Wojtascythe/lightsaber/ETAPIII/1.jpg

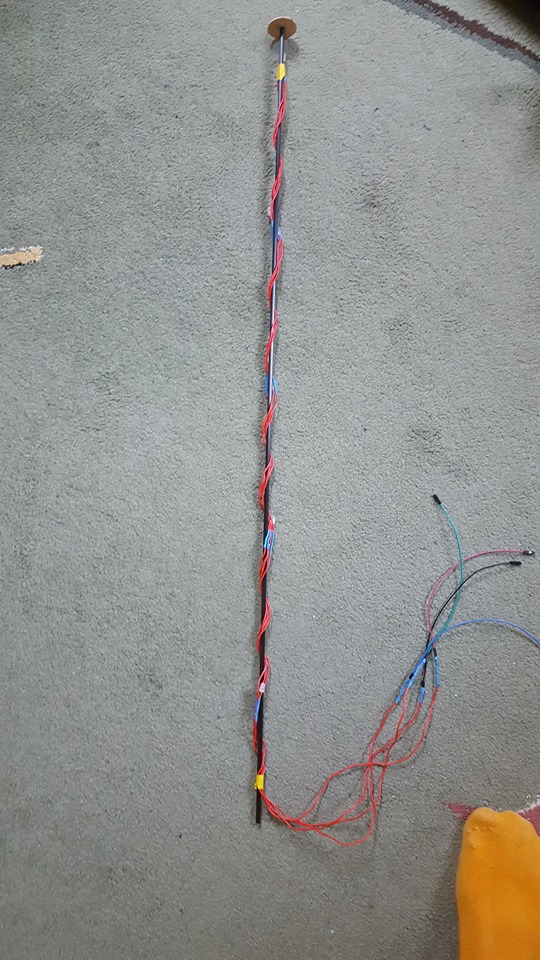
ETAPIII/1.jpg
