Wojtascythe/lightsaber/ETAPIII/5.jpg

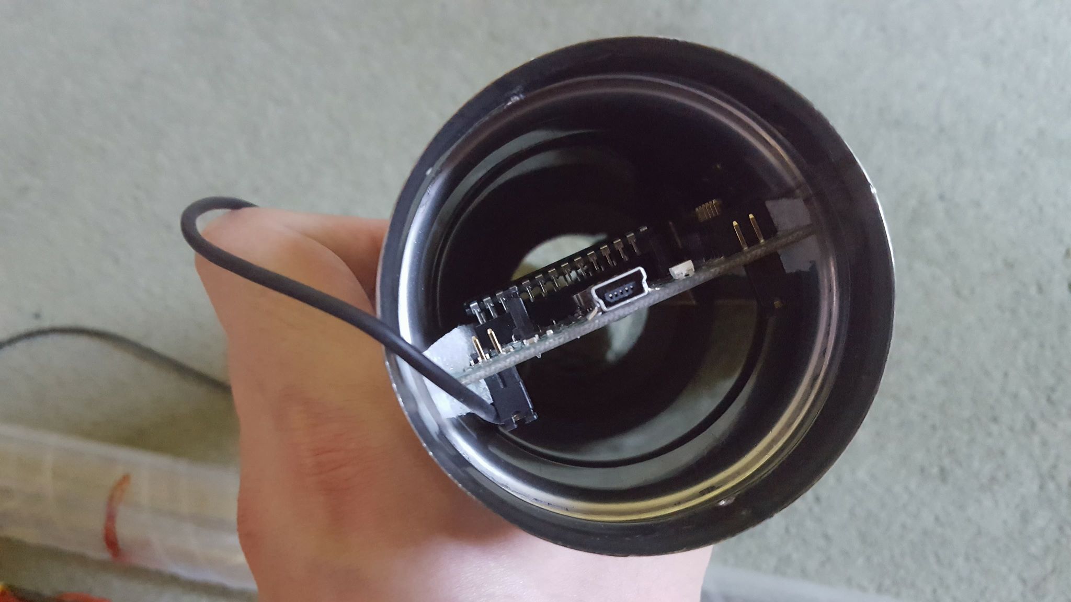
ETAPIII/5.jpg
