Wojtascythe/lightsaber/ETAPIII/7.jpg

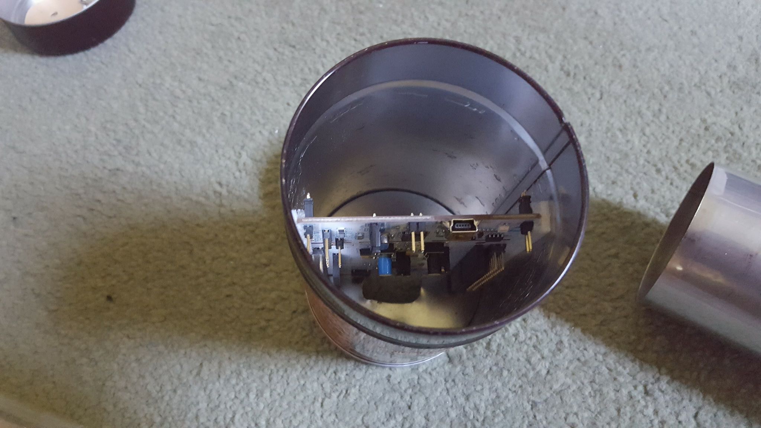
ETAPIII/7.jpg
