Wojtascythe/lightsaber/ETAPIII/8.jpg

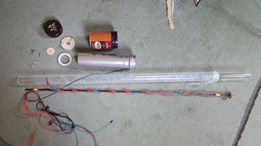
ETAPIII/8.jpg
