Wojtascythe/lightsaber/ETAPIII/10.jpg

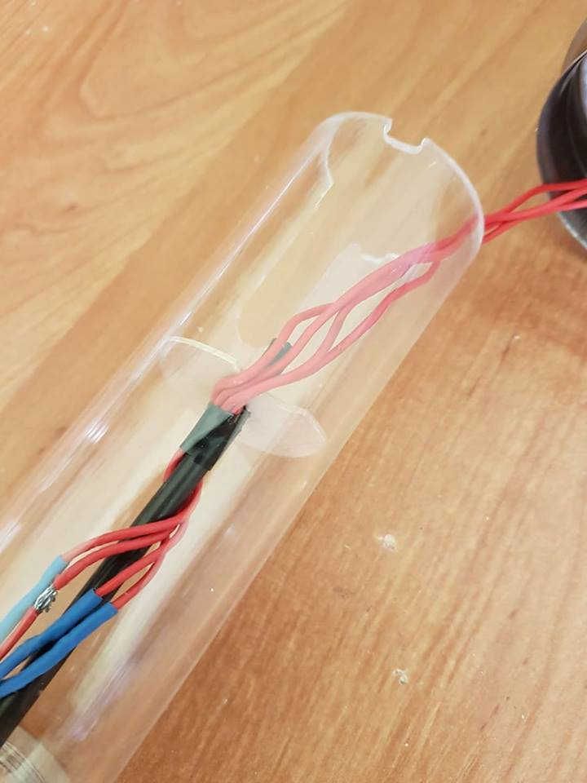
ETAPIII/10.jpg
