Wojtascythe/lightsaber/ETAPIII/14.jpg

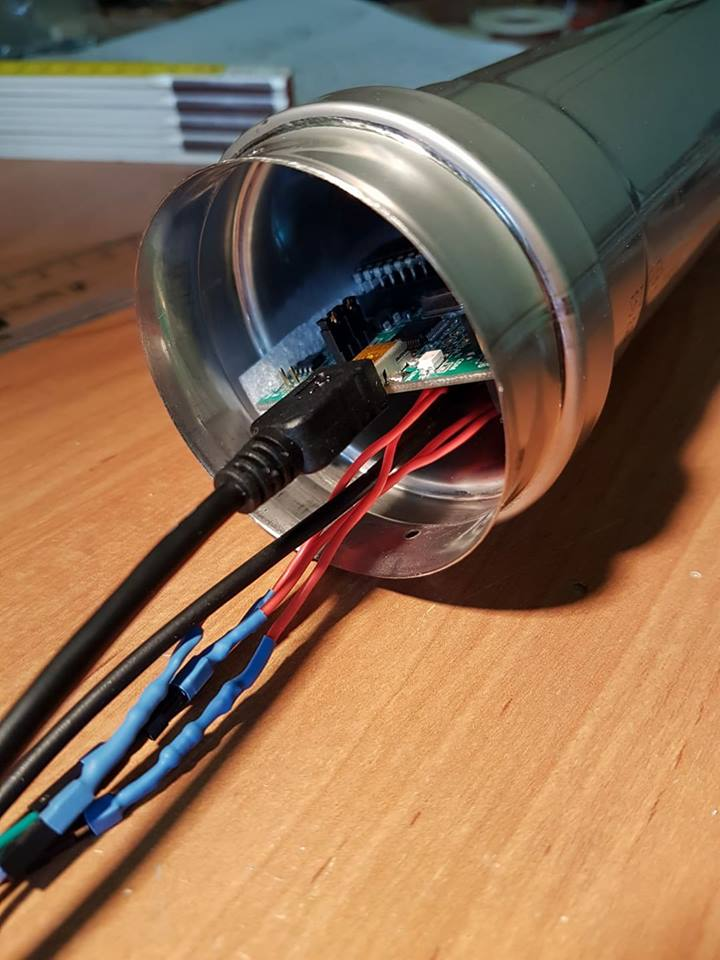
ETAPIII/14.jpg
