Wojtascythe/lightsaber/ETAPIII/15.jpg

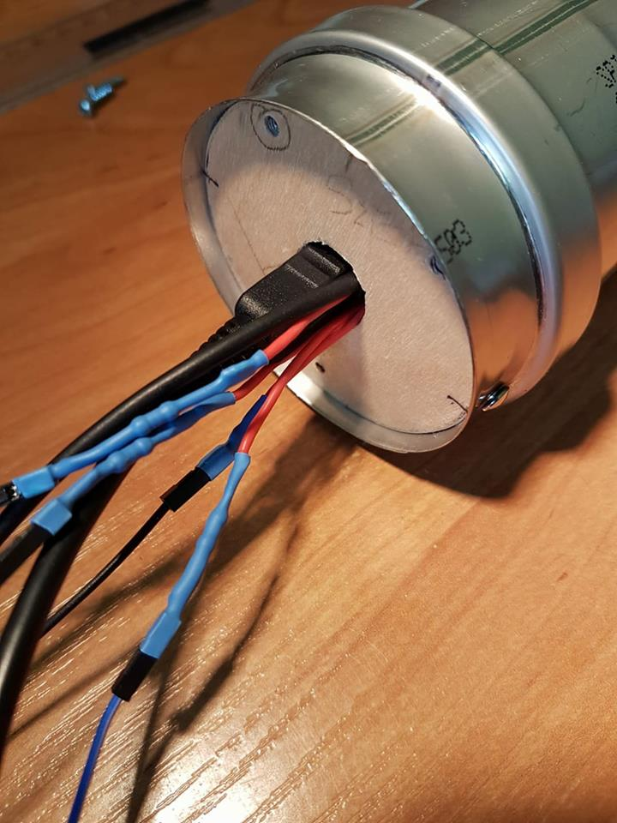
ETAPIII/15.jpg
