Wojtascythe/lightsaber/ETAPIII/16.jpg

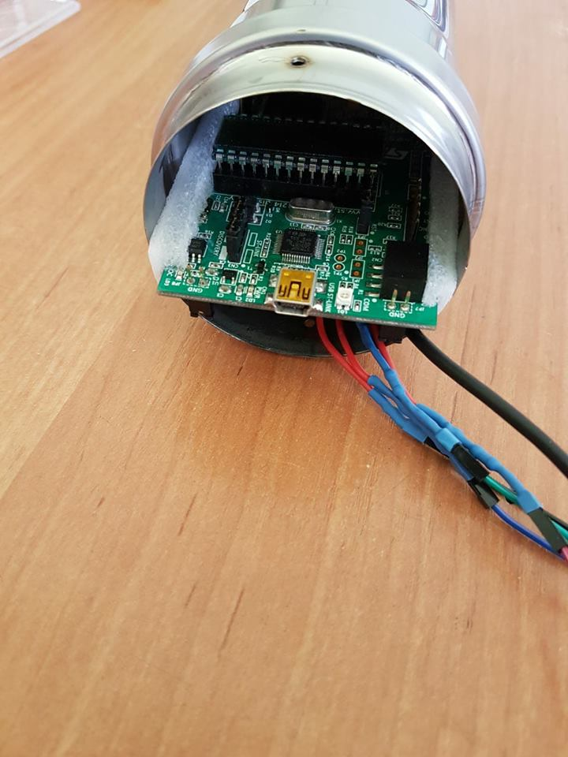
ETAPIII/16.jpg
