Wojtascythe/lightsaber/ETAPIII/17.jpg

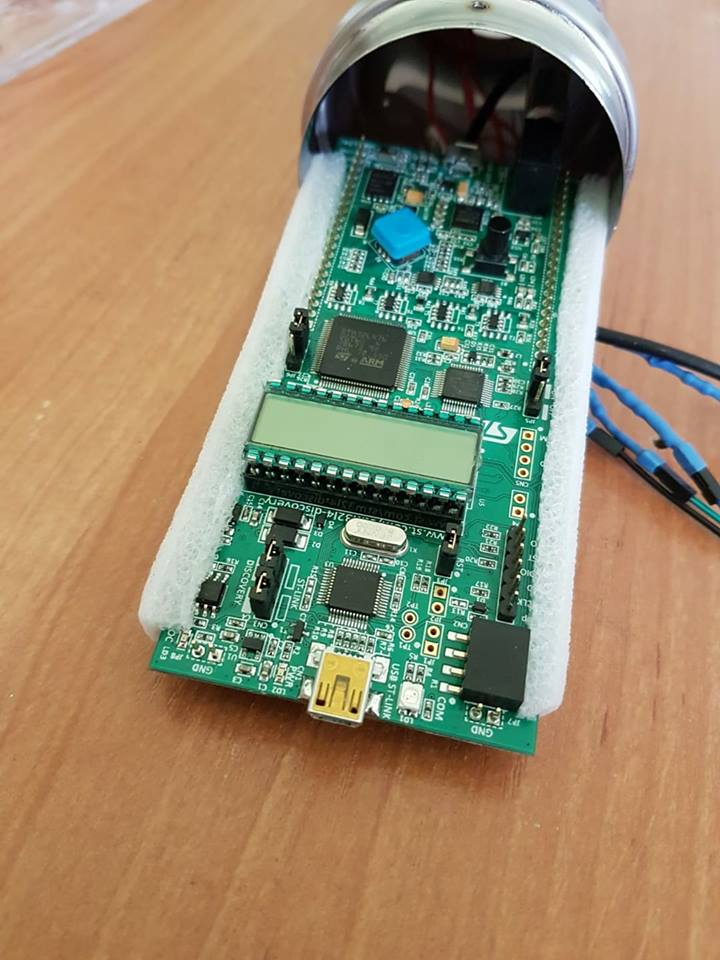
ETAPIII/17.jpg
