Wojtascythe/lightsaber/ETAPIII/18.jpg

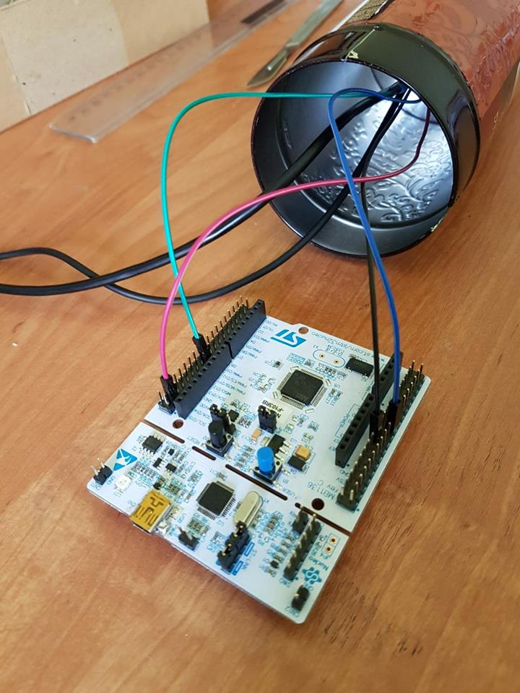
ETAPIII/18.jpg
