Wojtascythe/lightsaber/ETAPIII/20.jpg

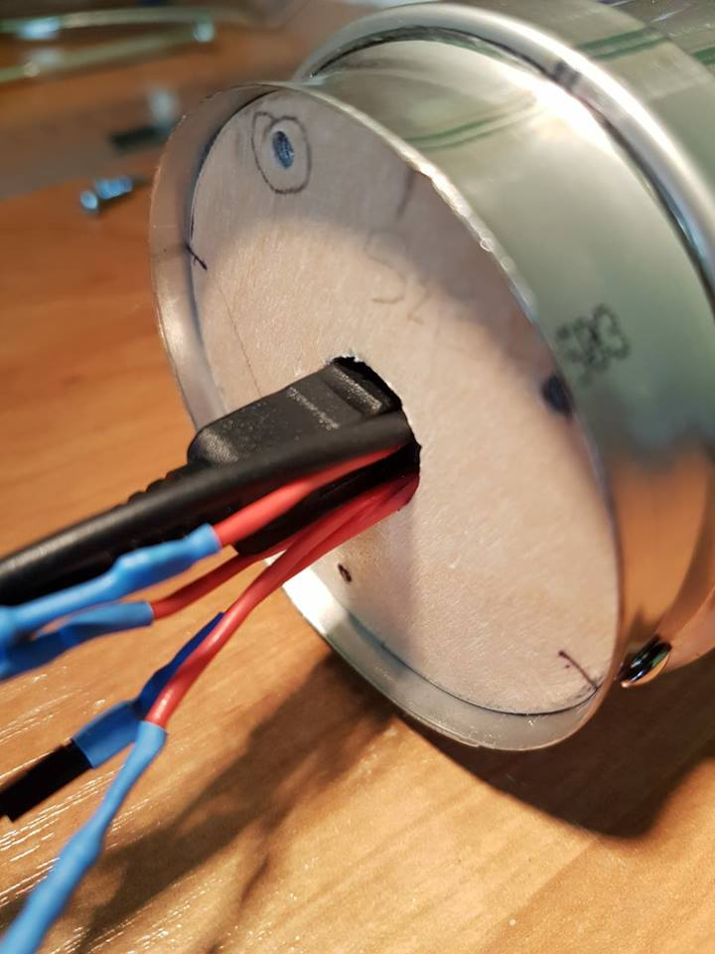
ETAPIII/20.jpg
