Wojtascythe/lightsaber/software/arm_firmware/Src/main.c

/**
  ******************************************************************************
  * @file           : main.c
  * @brief          : Main program body
  ******************************************************************************
  ** This notice applies to any and all portions of this file
  * that are not between comment pairs USER CODE BEGIN and
  * USER CODE END. Other portions of this file, whether 
  * inserted by the user or by software development tools
  * are owned by their respective copyright owners.
  *
  * COPYRIGHT(c) 2018 STMicroelectronics
  *
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
  ******************************************************************************
  */
/* Includes ------------------------------------------------------------------*/
#include "main.h"
#include "stm32l4xx_hal.h"
#include "dfsdm.h"
#include "dma.h"
#include "i2c.h"
#include "sai.h"
#include "spi.h"
#include "usart.h"
#include "gpio.h"

/* USER CODE BEGIN Includes */
#include "gyros.h"
#include "accel.h"

#include "stm32l476g_discovery_gyroscope.h"
#include "stm32l476g_discovery_compass.h"
#include "stm32l476g_discovery_audio.h"

#include "math.h"
#include "sample.h"

#define BASE_FREQ 400.0f
/* USER CODE END Includes */


/* USER CODE BEGIN PV */
uint8_t Received[10];
int32_t RemainingAudioSamplesNb;
volatile uint16_t * frameData, *genData;
uint16_t buffor1[800], buffor2[800];
volatile float cc = 0.0;
volatile uint8_t audioFlag = 0;

/* USER CODE END PV */

void SystemClock_Config(void);

/* USER CODE BEGIN PFP */
void AudioPlay_TransferComplete_CallBack() {
	if (audioFlag == 1) {
		if (frameData == buffor1) {
			frameData = buffor2;
		} else {
			frameData = buffor1;
		}
		audioFlag = 0;
	}

//	if(cc > 2.0){
//				frameData = light_saber_sample_move;
//
//			}else{
//				frameData = light_saber_sample_idle;
//
//			}


	if (BSP_AUDIO_OUT_Play(frameData, RemainingAudioSamplesNb) != AUDIO_OK) {
		HAL_GPIO_WritePin(LD_R_GPIO_Port, LD_R_Pin, SET);
		Error_Handler();
	} else {
		HAL_GPIO_TogglePin(LD_G_GPIO_Port, LD_G_Pin);
	}

}
void AudioPlay_Error_CallBack(void) {
	/* Stop the program with an infinite loop */
	HAL_GPIO_WritePin(LD_R_GPIO_Port, LD_R_Pin, SET);
	Error_Handler();
}

/* USER CODE END PFP */

/**
  * @brief  The application entry point.
  *
  * @retval None
  */
int main(void)
{
  /* USER CODE BEGIN 1 */
	float sampleRate = 8000.0; // hertz
	float freq = BASE_FREQ;         // hertz
	float duration = 0.1;       // seconds

	/* Gyroscope variables */
	uint8_t message[100], characters_count;
	int16_t buffer[3];
	float x, y, z;
	float nSamples = (duration * sampleRate);
	uint16_t i;
	uint8_t wiadom[100];
	uint8_t char_count;
	int16_t buffa[3] = { 0 };
	float buffg[3] = { 0 };
	float xa, ya, za, va = 0.0, xaa = 0.0, yaa = 0.0, zaa = 0.0;
	float xg, yg, zg;
	uint32_t interval = 0, prev = 0, current = 0;

	frameData = buffor1;
	//frameData = light_saber_sample;
  /* USER CODE END 1 */

  /* MCU Configuration----------------------------------------------------------*/

  /* Reset of all peripherals, Initializes the Flash interface and the Systick. */
  HAL_Init();

  /* Configure the system clock */
  SystemClock_Config();

  /* Initialize all configured peripherals */
  MX_GPIO_Init();
  MX_DMA_Init();
  MX_SAI1_Init();
  MX_I2C1_Init();
  MX_SPI2_Init();
  MX_USART2_UART_Init();
  MX_DFSDM1_Init();
  /* USER CODE BEGIN 2 */
	HAL_GPIO_WritePin(LD_G_GPIO_Port, LD_G_Pin, RESET);
	HAL_GPIO_WritePin(LD_R_GPIO_Port, LD_R_Pin, RESET);

	for (i = 0; i < (uint32_t) nSamples; ++i) {
		buffor1[i] = (uint16_t) ((sin(
				freq * (float) i * 6.28 / sampleRate) + 1.0) * 32000);
	}


	if (ZYROS_Init() != Zyros_ok) {
		HAL_GPIO_WritePin(LD_R_GPIO_Port, LD_R_Pin, SET);
		/* Initialization Error */
		Error_Handler();
	}

	if (AKCEL_Init() != Akcel_ok) {
		HAL_GPIO_WritePin(LD_R_GPIO_Port, LD_R_Pin, SET);
		/* Initialization Error */
		Error_Handler();
	}

	RemainingAudioSamplesNb = 800; //sizeof(light_saber_sample)/sizeof(uint16_t); //1600;//(uint32_t)nSamples;
	HAL_GPIO_WritePin(LD_R_GPIO_Port, LD_R_Pin, RESET);
	if (BSP_AUDIO_OUT_Init(OUTPUT_DEVICE_HEADPHONE, 60, 8000) != AUDIO_OK) {
		HAL_GPIO_WritePin(LD_R_GPIO_Port, LD_R_Pin, SET);
		Error_Handler();       //dajemy sygnal error
	}

	BSP_AUDIO_OUT_RegisterCallbacks(AudioPlay_Error_CallBack,
	NULL, AudioPlay_TransferComplete_CallBack);

	if (BSP_AUDIO_OUT_Play(frameData, RemainingAudioSamplesNb) != AUDIO_OK) {
		HAL_GPIO_WritePin(LD_R_GPIO_Port, LD_R_Pin, SET);

		Error_Handler();
	}

  /* USER CODE END 2 */

  /* Infinite loop */
  /* USER CODE BEGIN WHILE */
	while (1) {
  /* USER CODE END WHILE */

  /* USER CODE BEGIN 3 */
		AKCEL_GetXYZ(buffa);
		xa = ((float) buffa[0] /4096.0);
		ya = ((float) buffa[1] /4096.0);
		za = ((float) buffa[2] /4096.0);

		char_count = sprintf((char *) wiadom, "Xa: %f Ya: %f Za: %f\n", xa, ya,
				za);
		HAL_UART_Transmit(&huart2, wiadom, char_count, 0xFFFF);

		ZYROS_GetXYZ(buffg);
		xg = ((float) buffg[0] * 0.244 / 1000.0);
		yg = ((float) buffg[1] * 0.244 / 1000.0);
		zg = ((float) buffg[2] * 0.244 / 1000.0);

		char_count = sprintf((char *) wiadom, "Xg: %f Yg: %f Zg: %f\n", xg, yg,
				zg);
		HAL_UART_Transmit(&huart2, wiadom, char_count, 0xFFFF);


		current = HAL_GetTick();
					interval = current - prev;
					prev = current;
		xaa += xa * ((float)interval / 1000.0);
		yaa += ya * ((float)interval/ 1000.0);
		zaa += za * ((float)interval/ 1000.0);
		va = sqrt(xaa*xaa + yaa*yaa + zaa*zaa);
		char_count = sprintf((char *) wiadom, "V: %f\n", va);
				HAL_UART_Transmit(&huart2, wiadom, char_count, 0xFFFF);

				if(audioFlag == 0){
					freq = (340.0/(340.0-va)*BASE_FREQ);
					char_count = sprintf((char *) wiadom, "f: %f\n", freq);
									HAL_UART_Transmit(&huart2, wiadom, char_count, 0xFFFF);
					if(frameData == buffor1){
						genData = buffor2;
					}else{
						genData = buffor1;
					}
					for(i=0; i<nSamples; ++i ){
					          genData[i] = (uint16_t)((sin(freq*(float)i*6.28/sampleRate)+1.0)*32000);

					      }
					audioFlag = 1;
		}


		//cc = sqrt(xa*xa+ya*ya+za*za);


	}
  /* USER CODE END 3 */

}

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
/* USER CODE BEGIN 4 */

/**
 * @brief  Convert value to display string
 * @param  None
 * @retval None
 */

/* USER CODE END 4 */
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
