Wojtascythe/lightsaber/software/arm_firmware/arm_firmware.ioc

Mcu.UserName=STM32L476VGTx
PB2.GPIO_Label=LD_R [LED red]
PB2.Signal=GPIO_Output
PB6.GPIO_Label=I2C1_SCL [SSM-104-L-DH_SCL]
PB6.Signal=I2C1_SCL
PB7.GPIO_Label=I2C1_SDA [SSM-104-L-DH_SDA]
PB7.Signal=I2C1_SDA
PB8.GPIO_Label=GYRO_INT2 [L3D20_DRDY/INT2]
PB8.Signal=GPXTI8
PC0.GPIO_Label=MAG_CS [LSM303CTR_MAG_INT]
PC0.Signal=GPIO_Output
PC1.GPIO_Label=MAG_INT [LSM303CTR_MAG_INT]
PC1.Signal=GPIO_Input
PC2.GPIO_Label=MAG_DRDY [LSM303CTR_DRDY_MAG]
PC2.Signal=GPIO_Input
PD0.GPIO_Label=EXT_RST [SSM-104-L-DH_EXT_RST]
PD0.Signal=GPXTI0
PD1.GPIO_Label=MEMS_SCK [L3GD20_SCL/SPC]
PD1.Signal=SPI2_SCK
PD2.GPIO_Label=GYRO_INT1 [L3GD20_INT1]
PD2.Signal=GPXTI2
PD3.GPIO_Label=MEMS_MISO [L3GD20_SA0/SDO]
PD3.Signal=SPI2_MISO
PD4.GPIO_Label=MEMS_MOSI [L3GD20_SDA/SDI/SDO]
PD4.Signal=SPI2_MOSI
PD5.GPIO_Label=USART_TX
PD5.Signal=USART2_TX
PD6.GPIO_Label=USART_RX
PD6.Signal=USART2_RX
PD7.GPIO_Label=GYRO_CS [L3GD20_CS_I2C/SPI]
PD7.Signal=GPIO_Output
PE0.GPIO_Label=XL_CS [LSM303CTR_CS_XL]
PE0.Signal=GPIO_Output
PE1.GPIO_Label=XL_INT [LSM303CTR_INT_XL]
PE1.Signal=GPXTI1
PE2.GPIO_Label=SAI1_MCK [CS43L22_MCLK]
PE2.Signal=SAI1_MCLK_A
PE3.GPIO_Label=AUDIO_RST [CS43L22_RESET]
PE3.Signal=GPIO_Output
PE4.GPIO_Label=SAI1_FS [CS43L22_LRCK]
PE4.Signal=SAI1_FS_A
PE5.GPIO_Label=SAI1_SCK [CS43L22_SCLK]
PE5.Signal=SAI1_SCK_A
PE6.GPIO_Label=SAI1_SD [CS43L22_SDIN]
PE6.Signal=SAI1_SD_A
PE8.GPIO_Label=LD_G [LED_Green]
PE8.Signal=GPIO_Output
