Wojtascythe/lightsaber/software/arm_firmware/Src/spi.c

/**
  ******************************************************************************
  * File Name          : SPI.c
  * Description        : This file provides code for the configuration
  *                      of the SPI instances.
  ******************************************************************************
  ** This notice applies to any and all portions of this file
  * that are not between comment pairs USER CODE BEGIN and
  * USER CODE END. Other portions of this file, whether 
  * inserted by the user or by software development tools
  * are owned by their respective copyright owners.
  *
  * COPYRIGHT(c) 2018 STMicroelectronics
  *
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
  ******************************************************************************
  */

/* Includes ------------------------------------------------------------------*/
#include "spi.h"

#include "gpio.h"

/* USER CODE BEGIN 0 */



//uint32_t SpixTimeout = SPIx_TIMEOUT_MAX;            /*<! Value of Timeout when SPI communication fails */
////static SPI_HandleTypeDef SpiHandle;
/* USER CODE END 0 */

SPI_HandleTypeDef hspi2;

/* SPI2 init function */
void MX_SPI2_Init(void)
{

  hspi2.Instance = SPI2;
  hspi2.Init.Mode = SPI_MODE_MASTER;
  hspi2.Init.Direction = SPI_DIRECTION_1LINE;
  hspi2.Init.DataSize = SPI_DATASIZE_4BIT;
  hspi2.Init.CLKPolarity = SPI_POLARITY_LOW;
  hspi2.Init.CLKPhase = SPI_PHASE_1EDGE;
  hspi2.Init.NSS = SPI_NSS_SOFT;
  hspi2.Init.BaudRatePrescaler = SPI_BAUDRATEPRESCALER_32;
  hspi2.Init.FirstBit = SPI_FIRSTBIT_MSB;
  hspi2.Init.TIMode = SPI_TIMODE_DISABLE;
  hspi2.Init.CRCCalculation = SPI_CRCCALCULATION_DISABLE;
  hspi2.Init.CRCPolynomial = 7;
  hspi2.Init.CRCLength = SPI_CRC_LENGTH_DATASIZE;
  hspi2.Init.NSSPMode = SPI_NSS_PULSE_ENABLE;
  if (HAL_SPI_Init(&hspi2) != HAL_OK)
  {
    _Error_Handler(__FILE__, __LINE__);
  }

}

void HAL_SPI_MspInit(SPI_HandleTypeDef* spiHandle)
{

  GPIO_InitTypeDef GPIO_InitStruct;
  if(spiHandle->Instance==SPI2)
  {
    /* SPI2 clock enable */
    __HAL_RCC_SPI2_CLK_ENABLE();
  
    /**SPI2 GPIO Configuration    
    PD1     ------> SPI2_SCK
    PD3     ------> SPI2_MISO
    PD4     ------> SPI2_MOSI 
    */
    GPIO_InitStruct.Pin = MEMS_SCK_Pin|MEMS_MISO_Pin|MEMS_MOSI_Pin;
    GPIO_InitStruct.Mode = GPIO_MODE_AF_PP;
    GPIO_InitStruct.Pull = GPIO_NOPULL;
    GPIO_InitStruct.Speed = GPIO_SPEED_FREQ_VERY_HIGH;
    GPIO_InitStruct.Alternate = GPIO_AF5_SPI2;
    HAL_GPIO_Init(GPIOD, &GPIO_InitStruct);

  }
}

void HAL_SPI_MspDeInit(SPI_HandleTypeDef* spiHandle)
{

  if(spiHandle->Instance==SPI2)
  {
    /* Peripheral clock disable */
    __HAL_RCC_SPI2_CLK_DISABLE();
  
    /**SPI2 GPIO Configuration    
    PD1     ------> SPI2_SCK
    PD3     ------> SPI2_MISO
    PD4     ------> SPI2_MOSI 
    */
    HAL_GPIO_DeInit(GPIOD, MEMS_SCK_Pin|MEMS_MISO_Pin|MEMS_MOSI_Pin);

  }
} 

/* USER CODE BEGIN 1 */
// void SPIx_Write(uint8_t Byte)
//{
//  /* Enable the SPI */
//  __HAL_SPI_ENABLE(&hspi2);
//  /* check TXE flag */
//  while ((hspi2.Instance->SR & SPI_FLAG_TXE) != SPI_FLAG_TXE);
//
//  /* Write the data */
//  *((__IO uint8_t *)&hspi2.Instance->DR) = Byte;
//
//  /* Wait BSY flag */
//  while ((hspi2.Instance->SR & SPI_FLAG_BSY) == SPI_FLAG_BSY);
//
//  /* disable the SPI */
//  __HAL_SPI_DISABLE(&hspi2);
//}
//uint8_t SPIx_Read(void)
//{
//  uint8_t receivedbyte;
//
//  __HAL_SPI_ENABLE(&hspi2);
//  __DSB();
//  __DSB();
//  __DSB();
//  __DSB();
//  __DSB();
//  __DSB();
//  __DSB();
//  __DSB();
//  __HAL_SPI_DISABLE(&hspi2);
//
//  while ((hspi2.Instance->SR & SPI_FLAG_RXNE) != SPI_FLAG_RXNE);
//  /* read the received data */
//  receivedbyte = *(__IO uint8_t *)&hspi2.Instance->DR;
//
//  /* Wait for the BSY flag reset */
//  while ((hspi2.Instance->SR & SPI_FLAG_BSY) == SPI_FLAG_BSY);
//
//
//  return receivedbyte;
//}
//
//void SPIx_DeInit(void)
//{
//  if (HAL_SPI_GetState(&hspi2) != HAL_SPI_STATE_RESET)
//  {
//    /* SPI Deinit */
//    HAL_SPI_DeInit(&hspi2);
//    SPIx_MspDeInit();
//  }
//}
//void SPIx_MspDeInit(void)
//{
//  /* enable SPIx gpio clock */
//  DISCOVERY_SPIx_GPIO_CLK_ENABLE();
//
//  /* Unconfigure SPIx SCK, MOSI and MISO */
//  HAL_GPIO_DeInit(DISCOVERY_SPIx_GPIO_PORT, (DISCOVERY_SPIx_SCK_PIN | DISCOVERY_SPIx_MOSI_PIN | DISCOVERY_SPIx_MISO_PIN));
//
//  DISCOVERY_SPIx_GPIO_FORCE_RESET();
//  DISCOVERY_SPIx_GPIO_RELEASE_RESET();
//
//  /* Disable SPIx clock  */
//  DISCOVERY_SPIx_CLOCK_DISABLE();
//}
//
//uint8_t SPIx_WriteRead(uint8_t Byte)
//{
//  uint8_t receivedbyte;
//
//  /* Enable the SPI */
//  __HAL_SPI_ENABLE(&hspi2);
//  /* check TXE flag */
//  while ((hspi2.Instance->SR & SPI_FLAG_TXE) != SPI_FLAG_TXE);
//
//  /* Write the data */
//  *((__IO uint8_t *)&hspi2.Instance->DR) = Byte;
//
//  while ((hspi2.Instance->SR & SPI_FLAG_RXNE) != SPI_FLAG_RXNE);
//  receivedbyte = *((__IO uint8_t *)&hspi2.Instance->DR);
//
//  /* Wait BSY flag */
//  while ((hspi2.Instance->SR & SPI_FLAG_FTLVL) != SPI_FTLVL_EMPTY);
//  while ((hspi2.Instance->SR & SPI_FLAG_BSY) == SPI_FLAG_BSY);
//
//  /* disable the SPI */
//  __HAL_SPI_DISABLE(&hspi2);
//
//  return receivedbyte;
//}
/* USER CODE END 1 */

/**
  * @}
  */

/**
  * @}
  */

/************************ (C) COPYRIGHT STMicroelectronics *****END OF FILE****/
