Wojtascythe/lightsaber/software/arm_firmware/Inc/sample.h

/*
 * sample.h
 *
 *  Created on: 096018
 *      Author: Patryk Knapik 226302@student.pwr.edu.pl
 */

#ifndef SAMPLE_H_
#define SAMPLE_H_

uint16_t light_saber_sample_idle[] = {32490,
		35137,
		37942,
		40112,
		42664,
		44934,
		46840,
		48123,
		49276,
		50335,
		50861,
		50664,
		50224,
		49528,
		48611,
		47141,
		45765,
		44773,
		43826,
		42679,
		41772,
		41479,
		41451,
		41142,
		41177,
		42008,
		42732,
		43009,
		43570,
		44284,
		44645,
		44676,
		44490,
		44121,
		43486,
		42302,
		40711,
		38948,
		36851,
		34434,
		32062,
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
};

uint16_t light_saber_sample_move[] = {
		32000,
		32130,
		32508,
		33032,
		33470,
		33588,
		33113,
		31936,
		30029,
		27563,
		25231,
		22934,
		21085,
		20048,
		19328,
		18917,
		19259,
		19933,
		20299,
		20559,
		20545,
		19771,
		19056,
		18788,
		18438,
		18487,
		18979,
		20143,
		21719,
		23469,
		25602,
		26813,
		27959,
		29557,
		30378,
		31220,
		32461,
		34482,
		36389,
		38835,
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

};

#endif /* SAMPLE_H_ */
